m1llermiller/EDP4_Power_Delivery/INFO.txt

GitHub repository linked to this directory.
Will do all work on project using these local files which are saved here. 

git commands to use:

git status 
> shows whats been modified

git add .
> stages all modified and new files

git commit -m "comment"

git push
