m1llermiller/EDP4_Power_Delivery/BQ25756_DESIGN-CALC-V01X4.xlsx

Sheet: BQ2575X Design Calculator
 |  |  |  | BQ25756 Buck-Boost Battery Charger Design Calculator
 |  |  |  |  | View Password
 |  |  | = Input Box |  | BQ2575X
Step 1: Operating Specifications |  |  |  |  | Red Text = Conditional Formatting Conditions
 | Input Voltage - Min, VAC(min) | 18.5 | V | 18.5 V | 4.2 | 70
 | Input Voltage - Nom, VAC(nom) | 20 | V | 20 V | 4.2 | 70 | 18.5 | 21.5
 | Input Voltage - Max, VAC(max) | 21.5 | V | 21.5 V | 4.2 | 70
 | Battery Voltage, VBAT | 18.25 | V | 18.25 V | 3.3 | 70
 | Full Load Output Current, IOUT(max) | 14 | A | 14 A
 |  |  |  |  | Black Text = Lists or Formulas
Step 2: Switching Frequency
 | Desired Switching Frequency, FDFW | 250 | kHz | 250 kHz | 200 | 600
 | Recommended Switching Frequency Resistor, RFSW | 133.33 | kΩ | 133.333333333333 kΩ
 | Selected Switching Frequency Resistor, RFSW | 133 | kΩ | 133 kΩ | 40 | 200
 | Recognized Switching Frequency, FSW | 250.38 | kHz |  | 237.5 | 262.5
 | Boost Duty Cycle Limitation | 94.37 | %
 | Buck Duty Cylce Limitation | 96.24 | %
 | Boost Output Voltage Limitation at VAC(min) | N/A | V |  | 70 | 18.25
 | Boost Output Voltage Limitation at VAC(nom) | N/A | V |  | 70 | 18.25
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
