m1llermiller/EDP4_Power_Delivery/Power_management.step

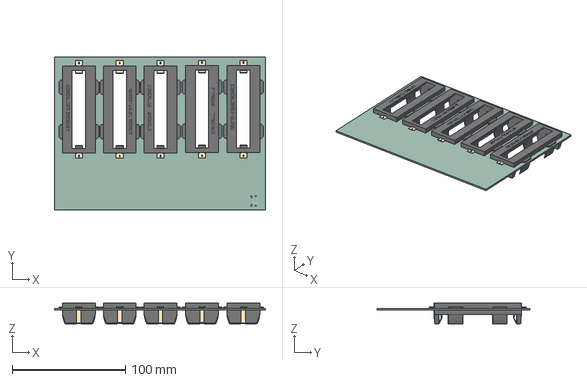
[picture p1: CAD file, 2026-02-26]
Power_management.step
186.0 x 135.0 x 18.4 mm
Power_management_PCB
