m1llermiller/EDP4_Power_Delivery/Testing Stage 1 MONITORING/Print Schematic.pdf

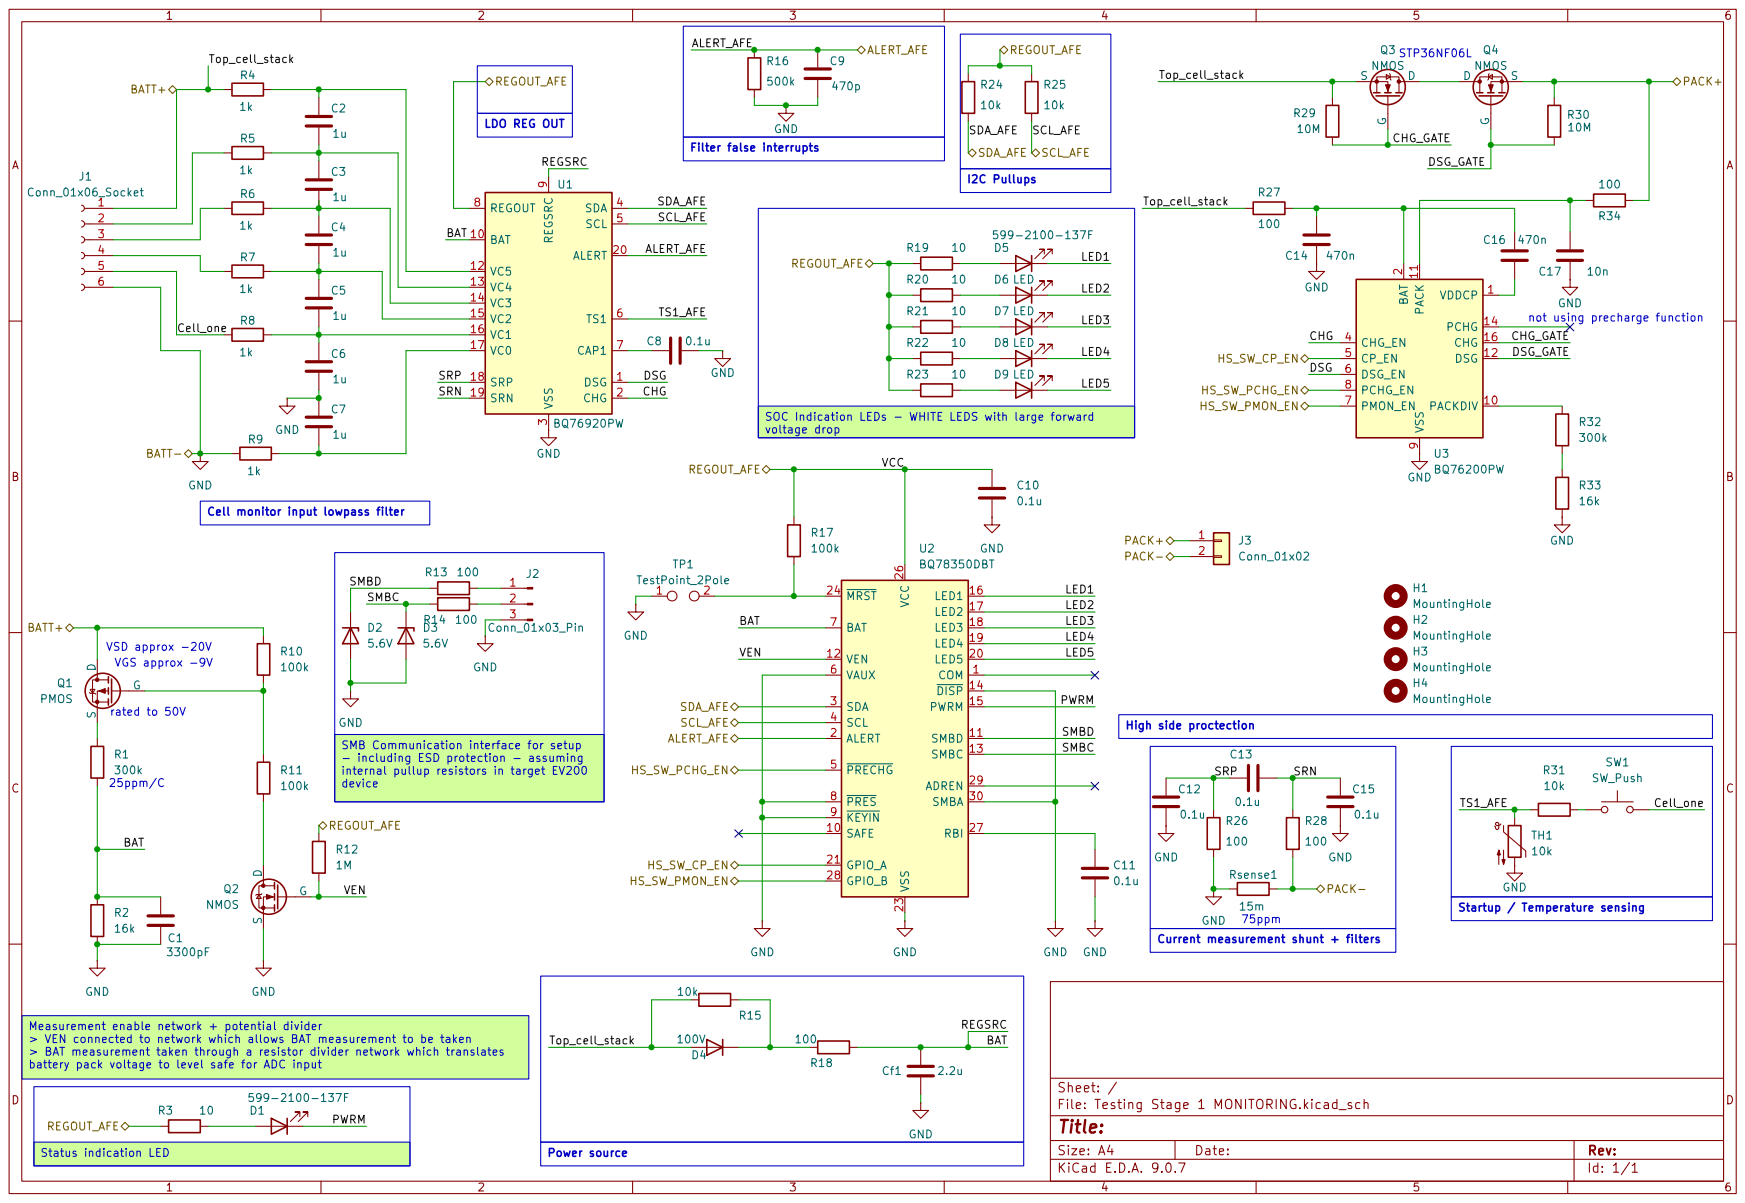
[picture p2: page 1]
