m1llermiller/EDP4_Power_Delivery/Power_management.kicad_pcb

## KiCad design Power_management.kicad_pcb (2026-03-22)

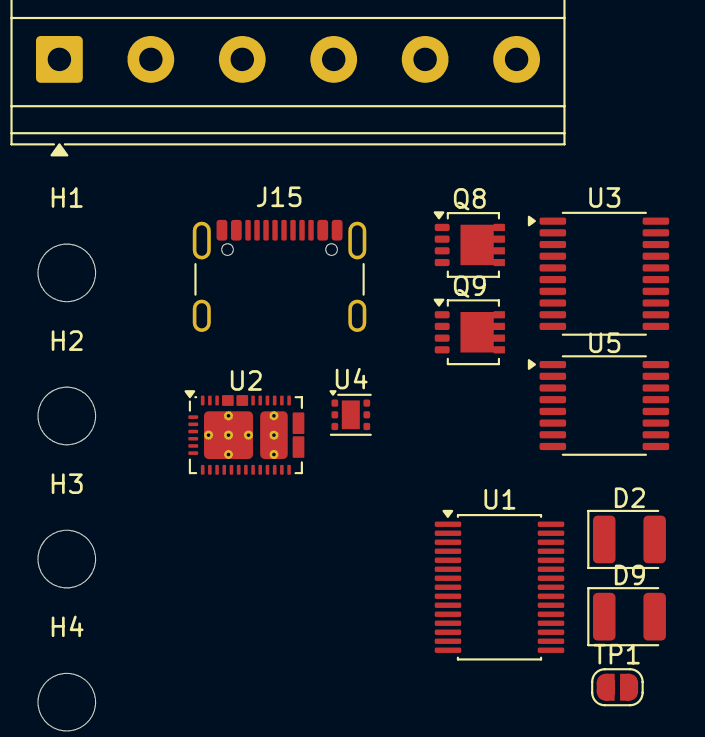
[picture p3: board Power_management.kicad_pcb from above]

Board: 2 copper layers, 16 parts (0 on the bottom side), 25 nets, no tracks yet.

Parts:
D2, D9: 599-2100-137F; LED_1210_3225Metric
H1, H2, H3, H4: MountingHole; MountingHole_3.2mm_M3
J5: Conn_01x06; TerminalBlock_Phoenix_MKDS-1,5-6-5.08_1x06_P5.08mm_Horizont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
J15: USB_C_Receptacle; USB_C_Receptacle_GCT_USB4105-xx-A_16P_TopMnt_Horizontal
Q8, Q9: BUK7M67-60EX; LFPAK33
TP1: TestPoint_2Pole; SolderJumper-2_P1.3mm_Open_RoundedPad1.0x1.5mm
U1: BQ78350DBT; TSSOP-30_4.4x7.8mm_P0.5mm
U2: TPS25730D; Texas_REF0038A_WQFN-38-2EP_6x4mm_P0.4
U3: BQ76920PW; TSSOP-20_4.4x6.5mm_P0.65mm
U4: TVS2200DRV; WSON-6-1EP_2x2mm_P0.65mm_EP1x1.6mm
U5: BQ76200PW; TSSOP-16_4.4x5mm_P0.65mm

Connections:
/Cell Controller/HS_SW_CP_EN: U1.21 (GPIO_A), U5.5 (CP_EN)
/Cell Controller/HS_SW_PCHG_EN: U1.5 (~PRECHG), U5.8 (PCHG_EN)
/Cell Controller/HS_SW_PMON_EN: U1.28 (GPIO_B), U5.7 (PMON_EN)
/Cell Controller/LED1: D2.1 (K), U1.16 (LED1)
/Cell Controller/PWRM: D9.1 (K), U1.15 (PWRM)
/Cell Controller/VCC: U1.26 (VCC), U3.8 (REGOUT)
/Cell Monitor/ALERT_AFE: U1.2 (ALERT), U3.20 (ALERT)
/Cell Monitor/BAT: U3.9 (REGSRC), U3.10 (BAT)
/Cell Monitor/CHG: U3.2 (CHG), U5.4 (CHG_EN)
/Cell Monitor/CHG_GATE: Q8.4 (G), U5.16 (CHG)
/Cell Monitor/DSG: U3.1 (DSG), U5.6 (DSG_EN)
/Cell Monitor/DSG_GATE: Q9.4 (G), U5.12 (DSG)
/Cell Monitor/PACK+: Q9.1 (S), Q9.2 (S), Q9.3 (S)
/Cell Monitor/SCL_AFE: U1.4 (SCL), U3.5 (SCL)
/Cell Monitor/SDA_AFE: U1.3 (SDA), U3.4 (SDA)
/Cell Monitor/Top_cell_stack: J5.1, Q8.1 (S), Q8.2 (S), Q8.3 (S)
/USB Interface/CC1: J15.A5 (CC1), U2.28 (CC1)
/USB Interface/CC2: J15.B5 (CC2), U2.29 (CC2)
/USB Interface/DRAIN: U2.15 (DRAIN), U2.30 (DRAIN), U2.40 (DRAIN)
/USB Interface/VBUS: U2.23 (VBUS_IN), U2.32 (VBUS)
GND: J5.6, J15.A1 (GND), J15.A12 (GND), J15.B1 (GND), J15.B12 (GND), J15.S1 (SHIELD), TP1.1, U1.6 (VAUX), U1.8 (~PRES), U1.9 (~KEYIN), U1.14 (~DISP), U1.22 (VSS), U1.23 (VSS), U1.25 (VSS), U1.30 (SMBA), U3.3 (VSS), U3.17 (VC0), U4.1 (GND), U4.2 (GND), U4.3 (GND), U4.7 (GND), U5.9 (VSS)
unnamed: J15.A4 (VBUS), J15.A9 (VBUS), J15.B4 (VBUS), J15.B9 (VBUS), U4.4 (IN), U4.5 (IN), U4.6 (IN)
unnamed: Q8.5 (D), Q9.5 (D)
unnamed: TP1.2, U1.24 (~MRST)
unnamed: U2.11 (GND), U2.12 (GND), U2.14 (GND), U2.16 (GND), U2.17 (GND), U2.31 (GND), U2.34 (GND), U2.39 (GND)
