m1llermiller/EDP4_Power_Delivery/Testing Stage 1 MONITORING/Testing Stage 1 MONITORING.kicad_pcb

## KiCad design Testing Stage 1 MONITORING/Testing Stage 1 MONITORING.kicad_pcb (2026-03-16)

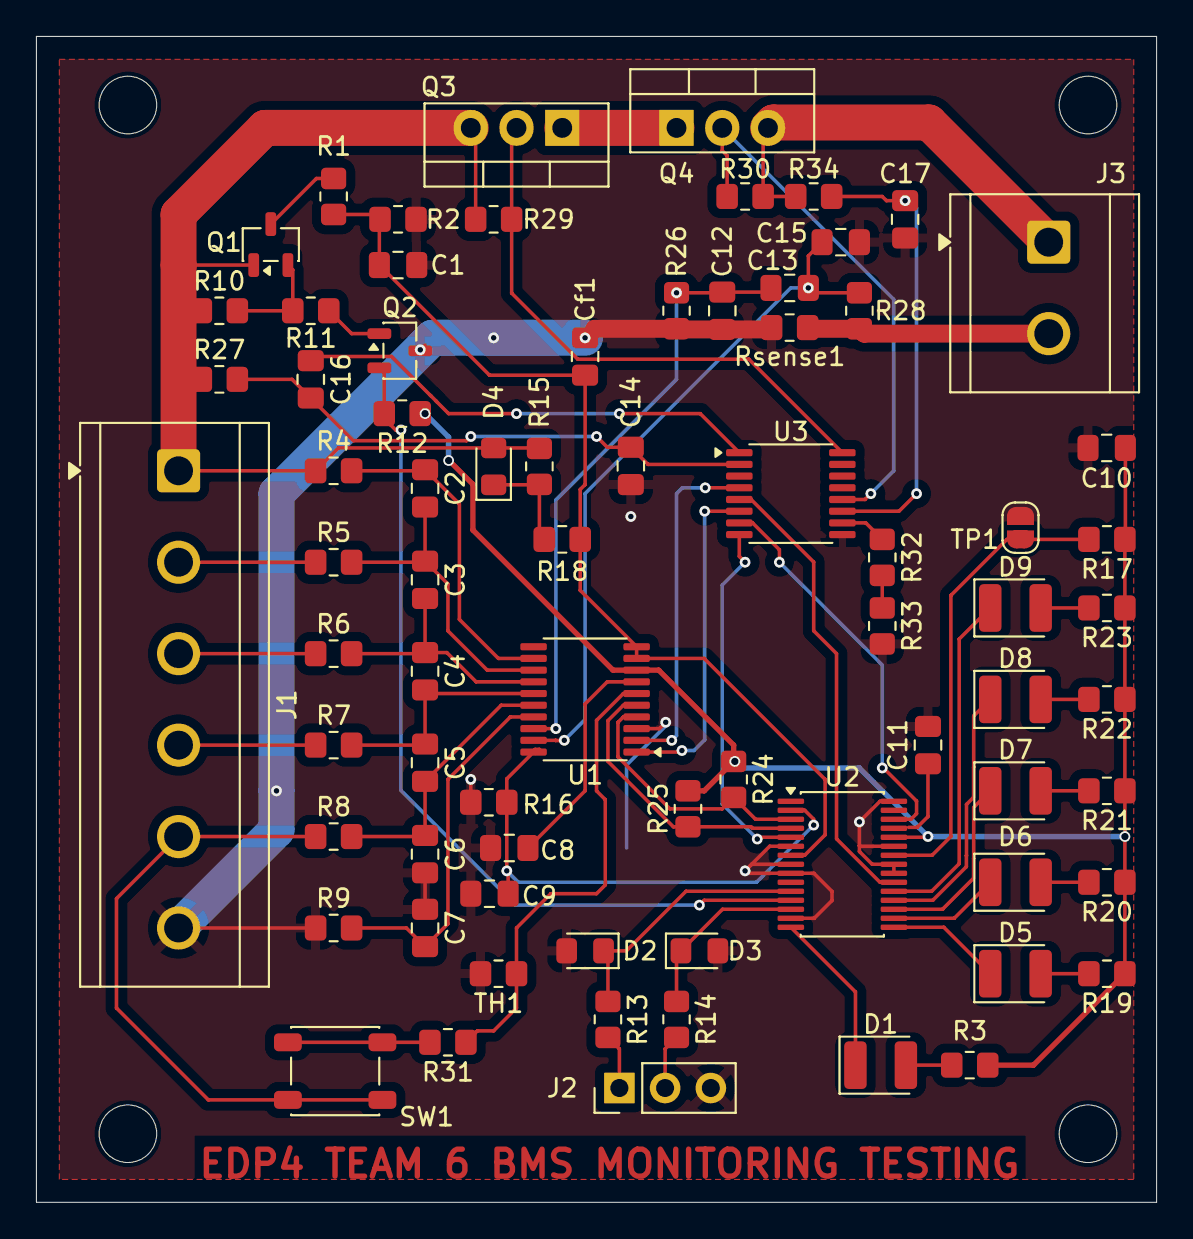
[picture p4: board Testing Stage 1 MONITORING.kicad_pcb from above]

Board: 2 copper layers, 62.2 x 64.8 mm, 79 parts (0 on the bottom side), 60 nets.

Parts:
C1: 3300pF; C_0805_2012Metric_Pad1.18x1.45mm_HandSolder
C2, C3, C4, C5, C6, C7: 1u; C_0805_2012Metric_Pad1.18x1.45mm_HandSolder
C8, C10, C11, C12, C13, C15: 0.1u; C_0805_2012Metric_Pad1.18x1.45mm_HandSolder
C9: 470p; C_0805_2012Metric_Pad1.18x1.45mm_HandSolder
C14, C16: 470n; C_0805_2012Metric_Pad1.18x1.45mm_HandSolder
C17: 10n; C_0805_2012Metric_Pad1.18x1.45mm_HandSolder
Cf1: 2.2u; C_0805_2012Metric_Pad1.18x1.45mm_HandSolder
D1, D5: 599-2100-137F; LED_1210_3225Metric
D2, D3: 5.6V; D_0805_2012Metric_Pad1.15x1.40mm_HandSolder
D4: 100V; D_0805_2012Metric_Pad1.15x1.40mm_HandSolder
D6, D7, D8, D9: LED; LED_1210_3225Metric
H1, H2, H3, H4: MountingHole; MountingHole_3.2mm_M3
J1: Conn_01x06_Socket; TerminalBlock_CUI_TB007-508-06_1x06_P5.08mm_Horizontal
J2: Conn_01x03_Pin; PinHeader_1x03_P2.54mm_Vertical
J3: Conn_01x02; TerminalBlock_CUI_TB007-508-02_1x02_P5.08mm_Horizontal
Q1: PMOS; SOT-23-3
Q2: NMOS; SOT-23-3
Q3, Q4: NMOS; TO-220-3_Vertical
R1, R32: 300k; R_0805_2012Metric_Pad1.20x1.40mm_HandSolder
R2, R33: 16k; R_0805_2012Metric_Pad1.20x1.40mm_HandSolder
R3, R19, R20, R21, R22, R23: 10; R_0805_2012Metric_Pad1.20x1.40mm_HandSolder
R4, R5, R6, R7, R8, R9: 1k; R_0805_2012Metric_Pad1.20x1.40mm_HandSolder
R10, R11, R17: 100k; R_0805_2012Metric_Pad1.20x1.40mm_HandSolder
R12: 1M; R_0805_2012Metric_Pad1.20x1.40mm_HandSolder
R13, R14, R18, R26, R27, R28, R34: 100; R_0805_2012Metric_Pad1.20x1.40mm_HandSolder
R15, R24, R25, R31: 10k; R_0805_2012Metric_Pad1.20x1.40mm_HandSolder
R16: 500k; R_0805_2012Metric_Pad1.20x1.40mm_HandSolder
R29, R30: 10M; R_0805_2012Metric_Pad1.20x1.40mm_HandSolder
Rsense1: 15m; R_0805_2012Metric_Pad1.20x1.40mm_HandSolder
SW1: SW_Push; SW_SPST_PTS647_Sx38
TH1: 10k; R_0805_2012Metric_Pad1.20x1.40mm_HandSolder
TP1: TestPoint_2Pole; SolderJumper-2_P1.3mm_Open_RoundedPad1.0x1.5mm
U1: BQ76920PW; TSSOP-20_4.4x6.5mm_P0.65mm
U2: BQ78350DBT; TSSOP-30_4.4x7.8mm_P0.5mm
U3: BQ76200PW; TSSOP-16_4.4x5mm_P0.65mm

Connections:
/ALERT_AFE: C9.1, R16.1, U1.20 (ALERT), U2.2 (ALERT)
/BAT: C1.1, Cf1.1, R1.2, R2.1, R18.2, U1.9 (REGSRC), U1.10 (BAT), U2.7 (BAT)
/CHG: U1.2 (CHG), U3.4 (CHG_EN)
/CHG_GATE: Q3.2 (G), R29.2, U3.16 (CHG)
/Cell_one: J1.5, R8.1, SW1.2
/DSG: U1.1 (DSG), U3.6 (DSG_EN)
/DSG_GATE: Q4.2 (G), R30.2, U3.12 (DSG)
/HS_SW_CP_EN: U2.21 (GPIO_A), U3.5 (CP_EN)
/HS_SW_PCHG_EN: U2.5 (~PRECHG), U3.8 (PCHG_EN)
/HS_SW_PMON_EN: U2.28 (GPIO_B), U3.7 (PMON_EN)
/LED1: D5.1 (K), U2.16 (LED1)
/LED2: D6.1 (K), U2.17 (LED2)
/LED3: D7.1 (K), U2.18 (LED3)
/LED4: D8.1 (K), U2.19 (LED4)
/LED5: D9.1 (K), U2.20 (LED5)
/PACK+: J3.1, Q4.3 (S), R30.1, R34.2
/PACK-: J3.2, R28.2, Rsense1.2
/PWRM: D1.1 (K), U2.15 (PWRM)
/SCL_AFE: R25.2, U1.5 (SCL), U2.4 (SCL)
/SDA_AFE: R24.2, U1.4 (SDA), U2.3 (SDA)
/SMBC: D3.1 (K), R14.1, U2.13 (SMBC)
/SMBD: D2.1 (K), R13.1, U2.11 (SMBD)
/SRN: C13.2, C15.1, R28.1, U1.19 (SRN)
/SRP: C12.1, C13.1, R26.1, U1.18 (SRP)
/TS1_AFE: R31.1, TH1.1, U1.6 (TS1)
/Top_cell_stack: D4.2 (A), J1.1, Q1.1 (D), Q3.3 (S), R4.1, R10.1, R15.1, R27.1, R29.1
/VCC: C10.1, R3.1, R12.1, R17.1, R19.1, R20.1, R21.1, R22.1, R23.1, R24.1, R25.1, U1.8 (REGOUT), U2.26 (VCC)
/VEN: Q2.2 (G), R12.2, U2.12 (VEN)
GND: C1.2, C6.2, C7.1, C8.2, C9.2, C10.2, C11.2, C12.2, C14.1, C15.2, C17.1, Cf1.2, D2.2 (A), D3.2 (A), J1.6, J2.3, Q2.3 (S), R2.2, R9.1, R16.2, R26.2, R33.2, Rsense1.1, TH1.2, TP1.1, U1.3 (VSS), U2.6 (VAUX), U2.8 (~PRES), U2.9 (~KEYIN), U2.14 (~DISP), U2.22 (VSS), U2.23 (VSS), U2.25 (VSS), U2.30 (SMBA), U3.9 (VSS)
unnamed: D1.2 (A), R3.2
unnamed: D4.1 (K), R15.2, R18.1
unnamed: D5.2 (A), R19.2
unnamed: D6.2 (A), R20.2
unnamed: D7.2 (A), R21.2
unnamed: D8.2 (A), R22.2
unnamed: D9.2 (A), R23.2
unnamed: J1.2, R5.1
unnamed: J1.3, R6.1
unnamed: J1.4, R7.1
unnamed: J2.1, R13.2
unnamed: J2.2, R14.2
unnamed: Q1.2 (G), R10.2, R11.1
unnamed: Q1.3 (S), R1.1
unnamed: Q2.1 (D), R11.2
unnamed: Q3.1 (D), Q4.1 (D)
unnamed: R31.2, SW1.1
unnamed: R32.2, R33.1
unnamed: C8.1, U1.7 (CAP1)
unnamed: C7.2, R9.2, U1.17 (VC0)
unnamed: C5.2, C6.1, R8.2, U1.16 (VC1)
unnamed: C4.2, C5.1, R7.2, U1.15 (VC2)
unnamed: C3.2, C4.1, R6.2, U1.14 (VC3)
unnamed: C2.2, C3.1, R5.2, U1.13 (VC4)
unnamed: C2.1, R4.2, U1.12 (VC5)
unnamed: C11.1, U2.27 (RBI)
unnamed: R17.2, TP1.2, U2.24 (~MRST)
unnamed: C14.2, C16.2, R27.2, U3.2 (BAT)
unnamed: C17.2, R34.1, U3.11 (PACK)
unnamed: R32.1, U3.10 (PACKDIV)
unnamed: C16.1, U3.1 (VDDCP)
