m1llermiller/EDP4_Power_Delivery/(commit log)

2026-01-30 beginning fuel gage layout
    [Power_management.kicad_sch, cell_controller.kicad_sch, cell_monitor.kicad_sch]
2026-01-30 starting usb pd charging
    [Power_management.kicad_sch, cell_monitor.kicad_sch, charger_ic.kicad_sch]
2026-02-08 usb pd charging
    [Power_management.kicad_sch, battery_pack.kicad_sch, cell_monitor.kicad_sch, charger_ic.kicad_sch, usb_interface.kicad_sch]
2026-03-03 progress on cell fuel gage
    [Power_management.kicad_sch, cell_controller.kicad_sch]
2026-03-06 structural changes
    [Power_management.csv, Power_management.kicad_sch, battery_pack.kicad_sch, buck_converters.kicad_sch, cell_controller.kicad_sch, charger_ic.kicad_sch, pwr_distro.kicad_sch, usb_interface.kicad_sch]
2026-03-07 development stage 1 - testing board for AFE / Fuel gage / high side protection controller - unfinished
    [Power_management.kicad_sch, Testing Stage 1 MONITORING.kicad_pcb, Testing Stage 1 MONITORING.kicad_sch, battery_pack.kicad_sch, cell_controller.kicad_sch, cell_monitor.kicad_sch, monitoring.kicad_sch]
2026-03-09 need to fix high side control IC - no need for precharge system
    [Testing Stage 1 MONITORING.kicad_pcb, Testing Stage 1 MONITORING.kicad_sch]
2026-03-10 fixed schematic, changed high side FETs, rough layout, still need to change footprints to 0805 so can be manufactured cheap at uni
    [Testing Stage 1 MONITORING.kicad_pcb, Testing Stage 1 MONITORING.kicad_sch]
2026-03-10 routing and layout updates
    [Testing Stage 1 MONITORING.kicad_pcb, Testing Stage 1 MONITORING.kicad_sch]
2026-03-10 updated layout and almost complete routing - need to address DRC
    [Testing Stage 1 MONITORING.kicad_pcb, Testing Stage 1 MONITORING.kicad_sch]
2026-03-10 working layout and routing no DRC error - but ugly
    [Testing Stage 1 MONITORING.kicad_pcb]
2026-03-16 refinements - moving battery pack off the PCB
    [Power_management.kicad_sch, Testing Stage 1 MONITORING.kicad_pcb, battery_pack.kicad_sch, cell_controller.kicad_sch, cell_monitor.kicad_sch, monitoring.kicad_sch, pwr_distro.kicad_sch]
2026-03-20 adding charging stages finally
    [BQ25756_DESIGN-CALC-V01X4.xlsx, Power_management.kicad_sch, battery_pack.kicad_sch, cell_controller.kicad_sch, cell_monitor.kicad_sch, charger_ic.kicad_sch, monitoring.kicad_sch, usb_interface.kicad_sch]
2026-03-20 finished charger schematic - still need to finalise usb
    [BQ25756_DESIGN-CALC-V01X4.xlsx, charger_ic.kicad_sch, usb_interface.kicad_sch]
